mohamedtareq24/QPulse-Tiny-ECG-classifier-ASIC/pnr/ADC.png

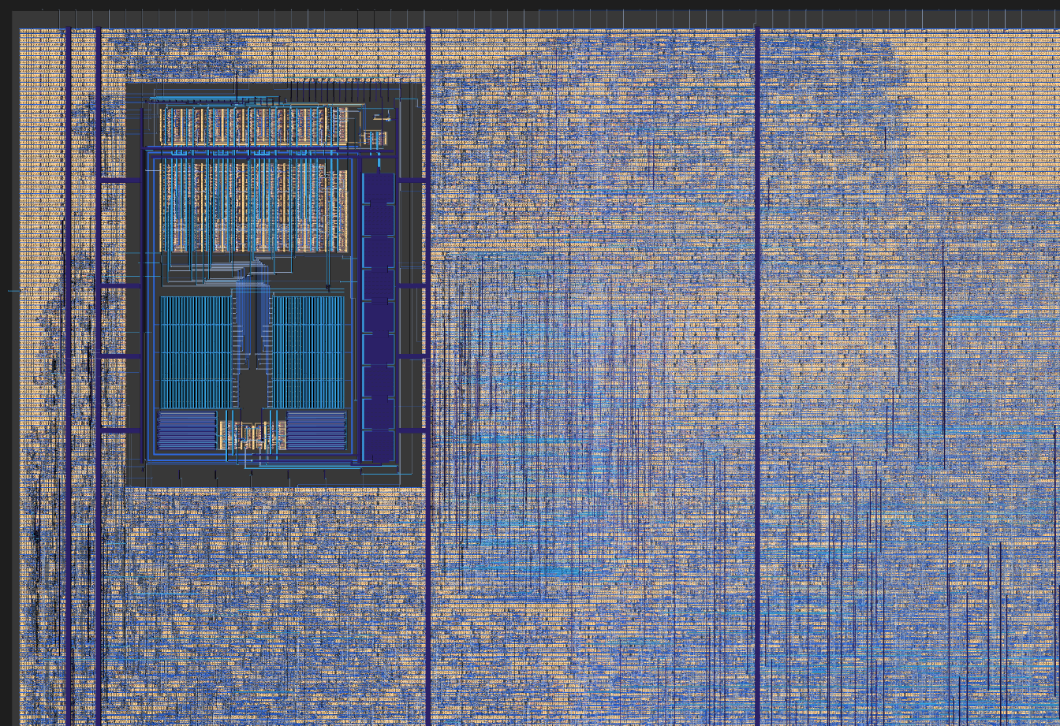
pnr/ADC.png
