mohamedtareq24/QPulse-Tiny-ECG-classifier-ASIC/pnr/final/render/project_macro.png

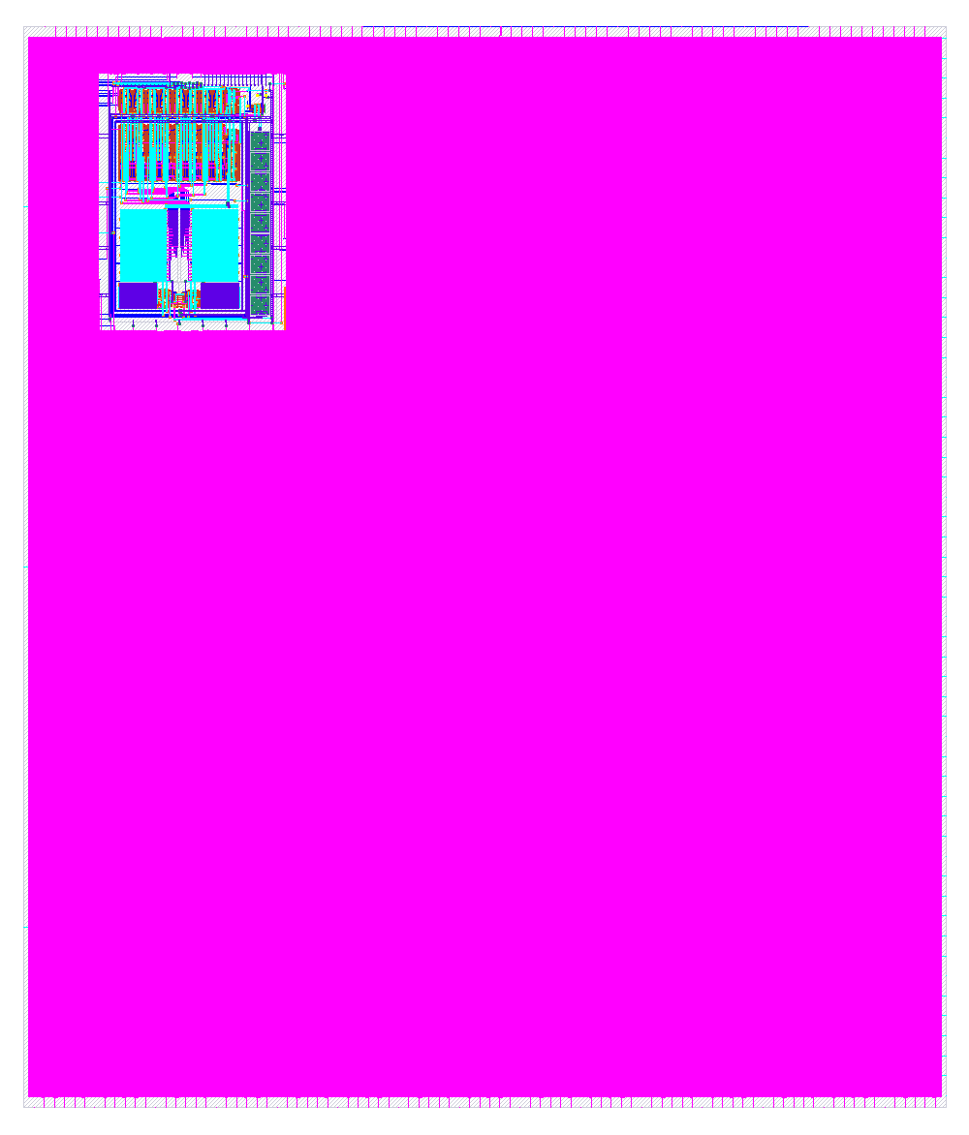
pnr/final/render/project_macro.png
