mohamedtareq24/QPulse-Tiny-ECG-classifier-ASIC/pnr/verilog/rtl/ecg_project_sources.v

// SPDX-License-Identifier: Apache-2.0
// ECG project source bundle for project_macro synthesis and simulation.

`include "../../../src/verilog/ecg_wrapper.v"
`include "../../../src/verilog/tiny_ecg_no_activ.v"
`include "../../../src/verilog/tiny_ecg_no_activ_conv_1d_cl_array_ap_fixed_1u_array_ap_fixed_10_5_5_3_0_2u_config2_s.v"
`include "../../../src/verilog/tiny_ecg_no_activ_conv_1d_cl_array_ap_fixed_1u_array_ap_fixed_10_5_5_3_0_2u_config2_s_outidx_2_bkb.v"
`include "../../../src/verilog/tiny_ecg_no_activ_conv_1d_cl_array_ap_fixed_1u_array_ap_fixed_10_5_5_3_0_2u_config2_s_w2_ROM_1Pcud.v"
`include "../../../src/verilog/tiny_ecg_no_activ_conv_1d_cl_array_ap_fixed_1u_array_ap_fixed_10_5_5_3_0_2u_config2_s_w2_ROM_AUcud.v"
`include "../../../src/verilog/tiny_ecg_no_activ_conv_1d_cl_array_ap_fixed_2u_array_ap_fixed_10_5_5_3_0_4u_config6_s.v"
`include "../../../src/verilog/tiny_ecg_no_activ_conv_1d_cl_array_ap_fixed_2u_array_ap_fixed_10_5_5_3_0_4u_config6_s_outidx_1_dEe.v"
`include "../../../src/verilog/tiny_ecg_no_activ_conv_1d_cl_array_ap_fixed_2u_array_ap_fixed_10_5_5_3_0_4u_config6_s_w6_ROM_1PeOg.v"
`include "../../../src/verilog/tiny_ecg_no_activ_conv_1d_cl_array_ap_fixed_2u_array_ap_fixed_10_5_5_3_0_4u_config6_s_w6_ROM_AUeOg.v"
`include "../../../src/verilog/tiny_ecg_no_activ_conv_1d_cl_array_array_ap_fixed_2u_config2_Pipeline_KernelShiftWidth.v"
`include "../../../src/verilog/tiny_ecg_no_activ_conv_1d_cl_array_array_ap_fixed_4u_config6_Pipeline_KernelShiftWidth.v"
`include "../../../src/verilog/tiny_ecg_no_activ_dense_array_ap_fixed_4u_array_ap_fixed_10_5_5_3_0_5u_config11_s.v"
`include "../../../src/verilog/tiny_ecg_no_activ_dense_array_ap_fixed_4u_array_ap_fixed_10_5_5_3_0_5u_config11_s_outidx_ROM_1PfYi.v"
`include "../../../src/verilog/tiny_ecg_no_activ_dense_array_ap_fixed_4u_array_ap_fixed_10_5_5_3_0_5u_config11_s_outidx_ROM_AUfYi.v"
`include "../../../src/verilog/tiny_ecg_no_activ_dense_array_ap_fixed_4u_array_ap_fixed_10_5_5_3_0_5u_config11_s_w11_ROM_1P_LUg8j.v"
`include "../../../src/verilog/tiny_ecg_no_activ_dense_array_ap_fixed_4u_array_ap_fixed_10_5_5_3_0_5u_config11_s_w11_ROM_AUTO_1R.v"
`include "../../../src/verilog/tiny_ecg_no_activ_dense_array_array_ap_fixed_10_5_5_3_0_5u_config11_Pipeline_DataPrepare.v"
`include "../../../src/verilog/tiny_ecg_no_activ_fifo_w20_d100000_A.v"
`include "../../../src/verilog/tiny_ecg_no_activ_fifo_w20_d1_S.v"
`include "../../../src/verilog/tiny_ecg_no_activ_fifo_w40_d100000_A.v"
`include "../../../src/verilog/tiny_ecg_no_activ_fifo_w40_d1_S.v"
`include "../../../src/verilog/tiny_ecg_no_activ_flow_control_loop_pipe.v"
`include "../../../src/verilog/tiny_ecg_no_activ_flow_control_loop_pipe_sequential_init.v"
`include "../../../src/verilog/tiny_ecg_no_activ_mul_10s_7s_15_1_1.v"
`include "../../../src/verilog/tiny_ecg_no_activ_mul_10s_8s_15_1_1.v"
`include "../../../src/verilog/tiny_ecg_no_activ_mux_10_4_10_1_1.v"
`include "../../../src/verilog/tiny_ecg_no_activ_mux_172_8_10_1_1.v"
`include "../../../src/verilog/tiny_ecg_no_activ_mux_2_1_10_1_1.v"
`include "../../../src/verilog/tiny_ecg_no_activ_mux_4_2_10_1_1.v"
`include "../../../src/verilog/tiny_ecg_no_activ_mux_5_3_10_1_1.v"
`include "../../../src/verilog/tiny_ecg_no_activ_pooling1d_cl_array_ap_fixed_2u_array_ap_fixed_10_5_5_3_0_2u_config5_s.v"
`include "../../../src/verilog/tiny_ecg_no_activ_pooling1d_cl_array_ap_fixed_4u_array_ap_fixed_10_5_5_3_0_4u_config9_s.v"
`include "../../../src/verilog/tiny_ecg_no_activ_regslice_both.v"
`include "../../../src/verilog/tiny_ecg_no_activ_relu_array_ap_fixed_2u_array_ap_fixed_10_5_5_3_0_2u_ReLU_config4_s.v"
`include "../../../src/verilog/tiny_ecg_no_activ_relu_array_ap_fixed_4u_array_ap_fixed_10_5_5_3_0_4u_ReLU_config8_s.v"
`include "../../../src/verilog/tiny_ecg_no_activ_start_for_conv_1d_cl_array_ap_fixed_2u_array_ap_fixed_10_5_5_3_0_4u_config6_U0.v"
`include "../../../src/verilog/tiny_ecg_no_activ_start_for_dense_array_ap_fixed_4u_array_ap_fixed_10_5_5_3_0_5u_config11_U0.v"
`include "../../../src/verilog/tiny_ecg_no_activ_start_for_pooling1d_cl_array_ap_fixed_2u_array_ap_fixed_10_5_5_3_0_2u_config5g8j.v"
`include "../../../src/verilog/tiny_ecg_no_activ_start_for_pooling1d_cl_array_ap_fixed_2u_array_ap_fixed_10_5_5_3_0_2u_config5hbi.v"
`include "../../../src/verilog/tiny_ecg_no_activ_start_for_pooling1d_cl_array_ap_fixed_4u_array_ap_fixed_10_5_5_3_0_4u_config9hbi.v"
`include "../../../src/verilog/tiny_ecg_no_activ_start_for_pooling1d_cl_array_ap_fixed_4u_array_ap_fixed_10_5_5_3_0_4u_config9ibs.v"
`include "../../../src/verilog/tiny_ecg_no_activ_start_for_relu_array_ap_fixed_2u_array_ap_fixed_10_5_5_3_0_2u_ReLU_config4_U0.v"
`include "../../../src/verilog/tiny_ecg_no_activ_start_for_relu_array_ap_fixed_4u_array_ap_fixed_10_5_5_3_0_4u_ReLU_config8_U0.v"
`include "../../../src/verilog/axis_uart_tx_bridge.v"
`include "../../../src/verilog/uart_rx_axis_bridge.v"
`include "../../../src/verilog/uart_rx.v"
`include "../../../src/verilog/uart_tx.v"
