mohamedtareq24/QPulse-Tiny-ECG-classifier-ASIC/fpga/testing/adc_uvm/uart_vif.py

"""Virtual interface for ECG UART wrapper."""


class ECGUartVif:
    """Wraps the DUT pins for the ECG UART interface.
    
    Pins:
      clk     - clock (input to DUT)
      arst_n  - async reset, active low (input to DUT)
      rx      - UART receive from host (input to DUT)
      tx      - UART transmit to host (output from DUT)
    """

    def __init__(self, dut):
        self.dut = dut
        self.clk = dut.clk
        self.arst_n = dut.arst_n
        self.rx = dut.rx
        self.tx = dut.tx
        self.adc_valid = dut.adc_valid
        self.adc_data  = dut.adc_data
        self.adc_ready = dut.adc_ready
