mohamedtareq24/QPulse-Tiny-ECG-classifier-ASIC/(commit log)

2026-04-15 Repo Clone from Classroom
    [metrics.csv, pin_order.cfg]
2026-04-21 Add multi-epoch UART test script for ecg_wrapper on FPGA for Basic testing
2026-04-21 Update README.md to refine project description and emphasize HIL flow
2026-04-21 Update README.md to clarify HIL flow and adjust section order for improved navigation
2026-05-17 feat: add PnR config and final GDSII/LVS/SPEF outputs
    [macro.cfg, metrics.csv, project_macro__max_ff_n40C_1v95.sdf, project_macro__max_ss_100C_1v60.sdf, project_macro__max_tt_025C_1v80.sdf, project_macro__min_ff_n40C_1v95.sdf, project_macro__min_ss_100C_1v60.sdf, project_macro__min_tt_025C_1v80.sdf]
2026-05-17 feat: add utility scripts and MATLAB ECG analysis
    [bw.csv, em.csv, ma.csv]
