mohamedtareq24/QPulse-Tiny-ECG-classifier-ASIC/(notices)

Notices in the files:
README.md:
License: Apache 2.0
